DevarakondaV/WEB-Project-E-Race/E-Race Application/README.md

This folder contains the files associated with the WPF applciation required to control the WEB/E-race board.
