DevarakondaV/WEB-Project-E-Race/ESP8266Files/README.md

This folder contains the required files for an ESP8266 wifi module running on micropython. Each of the files in this directory
need to be uploaded to the ESP8266 board. 

NOTE:
The contents of boot.py file must be changed in order for someone to connect to the internet.

1) Change NID variable to the proper network ID.
2) Change NPW variable to the proper network password.
