DevarakondaV/WEB-Project-E-Race/Arduino/E-Race-Source/README.md

The E-Race-Source file contains the arduino program.
